jhu-dvrk/espm-programmer-pcba/dvrk-s-programmer.step

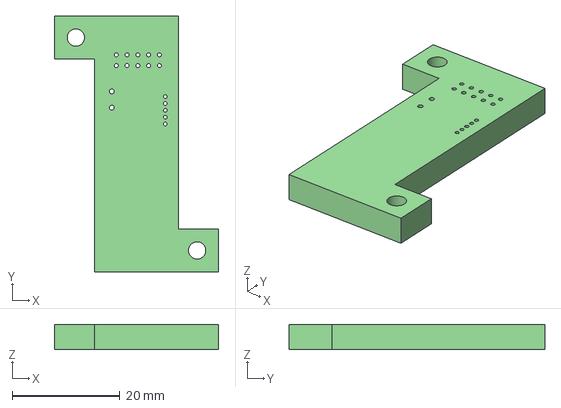
[picture p1: CAD file, 2022-09-01]
dvrk-s-programmer.step
30.5 x 47.5 x 4.69 mm
