jhu-dvrk/espm-programmer-pcba/(commit log)

2023-01-26 replaced swd port. changed silkscreen. made a little narrower. 1.2release
    [dvrk-s-programmer.kicad_pcb, dvrk-s-programmer.kicad_sch]
2023-12-21 v1.3: replaced SD card slot
    [dvrk-s-programmer.kicad_pcb, dvrk-s-programmer.kicad_sch]
